PoH-Sirius/prototype1/pressure-haptics/grip_v6_clickfit_spring_variants/README.txt

V6: 着脱式クリックフィット＋ばね太さ比較版

おすすめ手順
1. 最初に PRINT_FIT_TEST_2_parts.stl を100%で印刷する。
2. テスト片を差し込み、軽いクリック感で止まり、手で引いて外せることを確認する。
3. ばねの感触を比較する場合は PRINT_SPRING_TEST_4_variants.stl を100%で印刷する。
   配置は左から1.8 / 2.0 / 2.2 / 2.4 mm。プレートから外す前に油性ペン等で太さを書く。
4. 2.0 mmばねと握り部分をまとめて交換する場合は PRINT_GRIP_3_parts_2.0mm.stl を印刷する。
5. ケースも含めて全部印刷する場合だけ full_set/PRINT_ALL_9_parts.stl を使う。ここには2.0 mmばねを収録。

変更点
- 21 x 19 mmの圧力センサー貼付面と、握りパーツ全長64 mmはV4のまま。
- ばね端を二股の弾性タブに変更。
- タブ両側に0.30 mmの傾斜付き保持突起を追加。
- 受け穴は入口4.15 mm、奥4.60 mmの二段形状。奥で突起が戻って保持する。
- 差込深さを3.3 mmから6.2 mmへ増やし、横揺れも減らした。
- 挿入と取り外しの両方向に傾斜があるため、接着せず繰り返し着脱できる。
- しなる蛇行部分だけを1.8 / 2.0 / 2.2 / 2.4 mmの4段階で用意。
- 接続タブは全種類で同じ寸法なので、同じ左右プレートへ交換して比較できる。

使い方
- ばね端を穴にまっすぐ押し込み、クリック感が出るまで差し込む。
- 外すときは握りパーツを押さえ、ばねの端に近い太い部分をまっすぐ引く。
- 蛇行している薄い部分を強くねじらない。

印刷
- PLA想定、0.4 mmノズル、積層0.20 mm、壁3周以上。
- サポートは通常不要。STLの向きを変更せず100%で印刷。
- 初層が強く潰れる設定では受け穴が狭くなるため、テスト片で先に確認。

注意
太さを上げるほど押し込み量は減り、親指側と人差し指側の振動も伝わりにくくなる一方、必要な指の力は増える。
プリンター、材料、温度で嵌合と硬さは変わるため、実機での着脱耐久と振動絶縁は未検証。
硬すぎる場合は無理に押し込まず、受け穴入口のバリだけを軽く除去する。
