PoH-Sirius/prototype1/pressure-haptics/grip_v6_clickfit_spring_variants/preview_clickfit.png

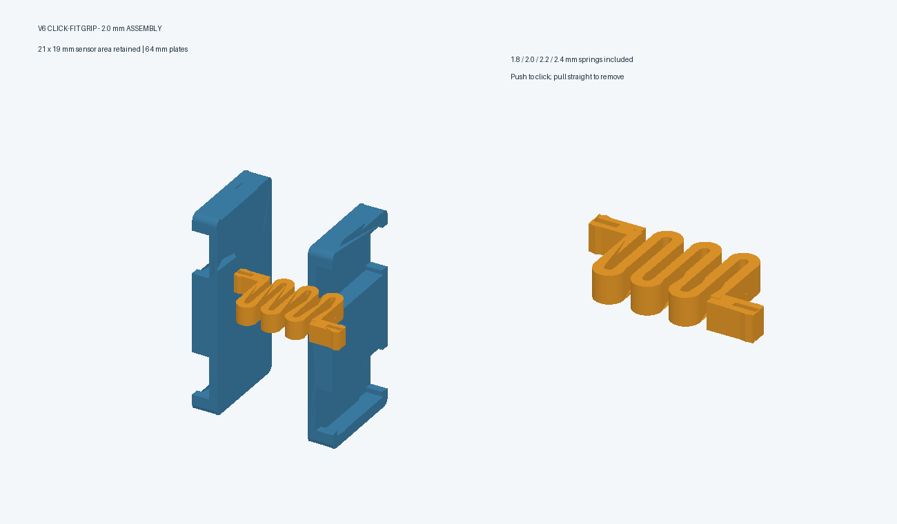
pressure-haptics/grip_v6_clickfit_spring_variants/preview_clickfit.png
