PoH-Sirius/prototype1/pressure-haptics/grip_v6_clickfit_spring_variants/grip_assembly_clickfit_2.0mm.step

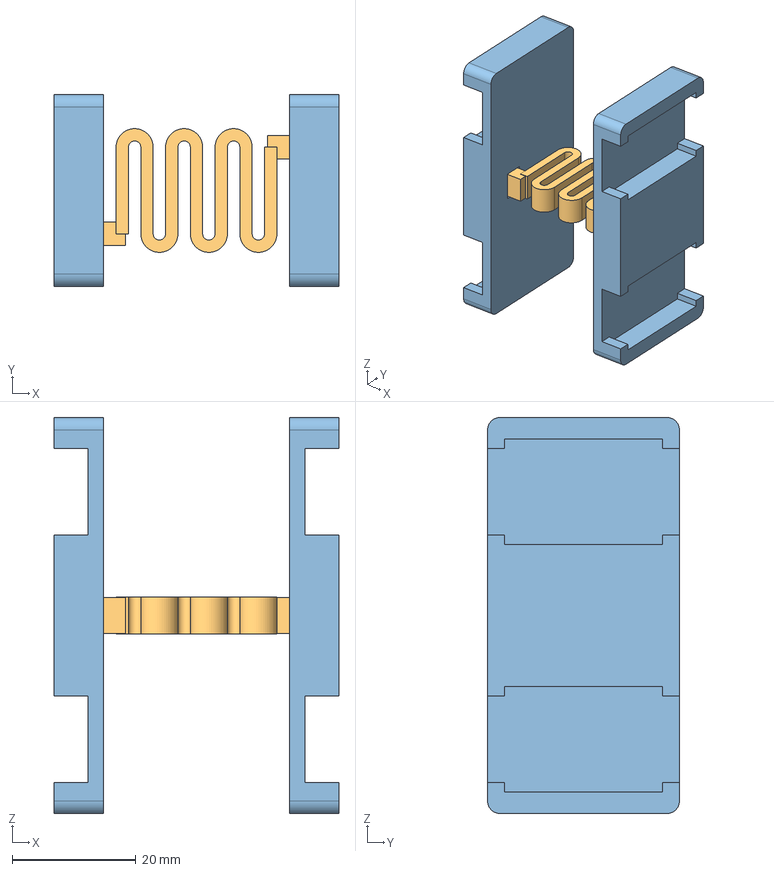
[picture p2: CAD file, 2026-09-29]
pressure-haptics/grip_v6_clickfit_spring_variants/grip_assembly_clickfit_2.0mm.step
46.0 x 31.0 x 64.0 mm
left
right
spring_clickfit
