PoH-Sirius/prototype1/pressure-haptics/grip_v6_clickfit_spring_variants/full_set/plate_left.step

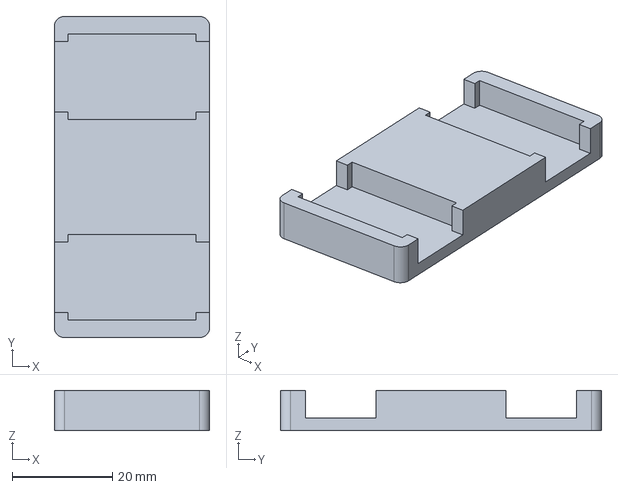
[picture p3: CAD file, 2026-09-29]
pressure-haptics/grip_v6_clickfit_spring_variants/full_set/plate_left.step
31.0 x 64.0 x 8.00 mm
