PoH-Sirius/prototype1/pressure-haptics/grip_v7_case_wiring_clearance/case_base_v7.step

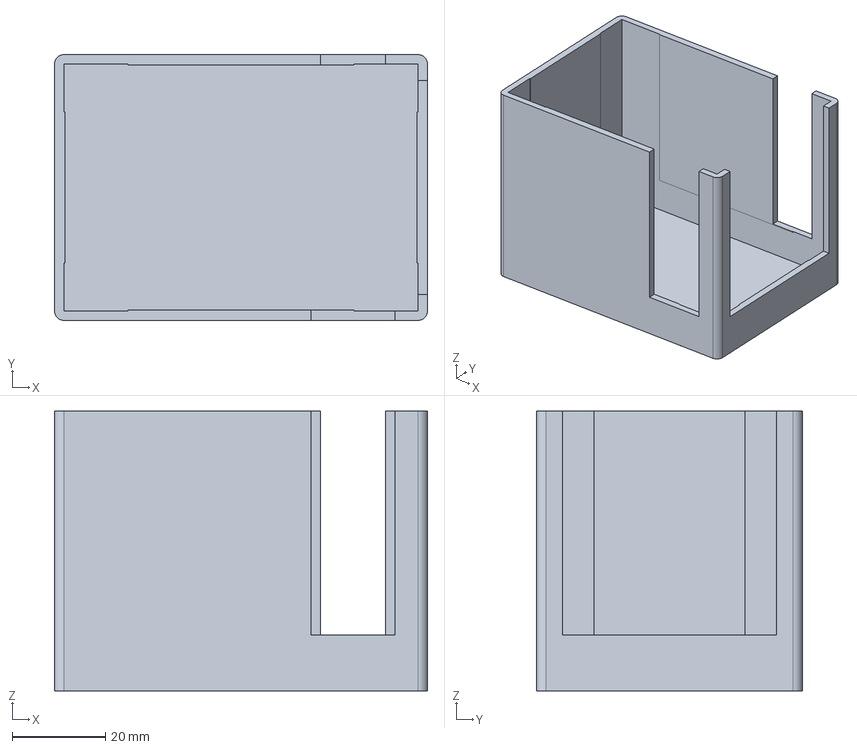
[picture p4: CAD file, 2026-09-29]
pressure-haptics/grip_v7_case_wiring_clearance/case_base_v7.step
80.0 x 57.0 x 60.0 mm
