PoH-Sirius/prototype1/pressure-haptics/grip_v7_case_wiring_clearance/full_set/print_layout_9_parts_v7.step

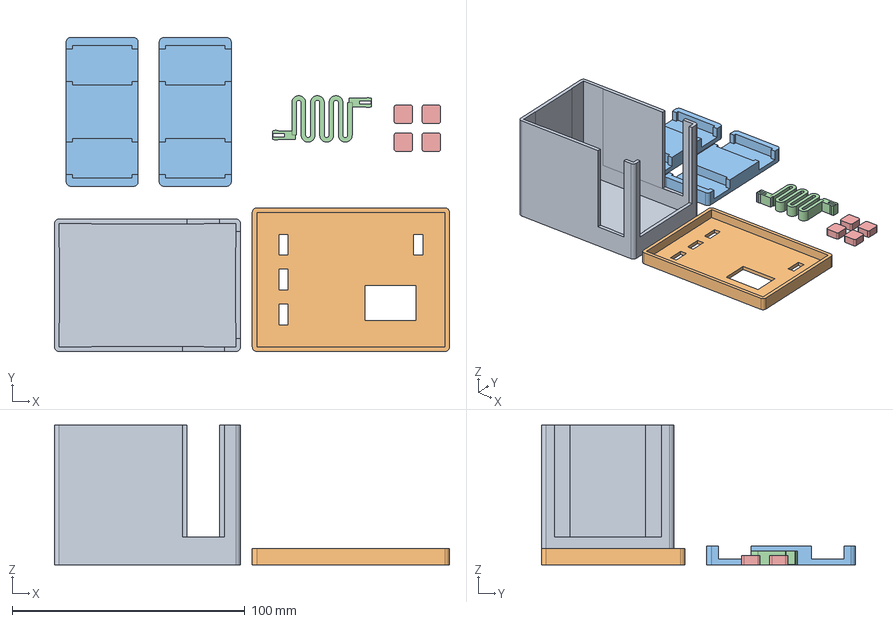
[picture p5: CAD file, 2026-09-29]
pressure-haptics/grip_v7_case_wiring_clearance/full_set/print_layout_9_parts_v7.step
169.8 x 135.0 x 60.0 mm
