PoH-Sirius/prototype1/pressure-haptics/grip_v6_clickfit_spring_variants/full_set/print_layout_9_parts.step

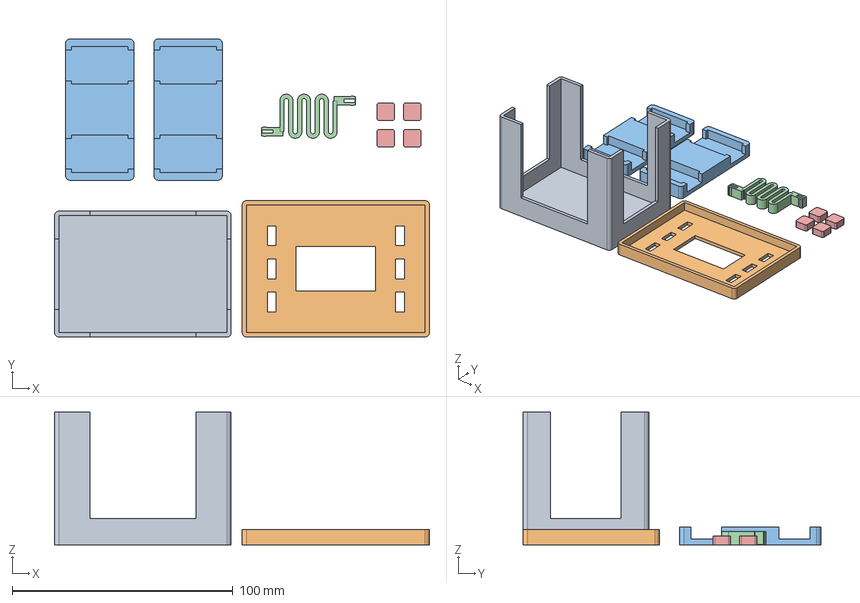
[picture p6: CAD file, 2026-09-29]
pressure-haptics/grip_v6_clickfit_spring_variants/full_set/print_layout_9_parts.step
169.8 x 135.0 x 60.0 mm
