PoH-Sirius/prototype1/pressure-haptics/grip_v6_clickfit_spring_variants/PRINT_FIT_TEST_2_parts.stl

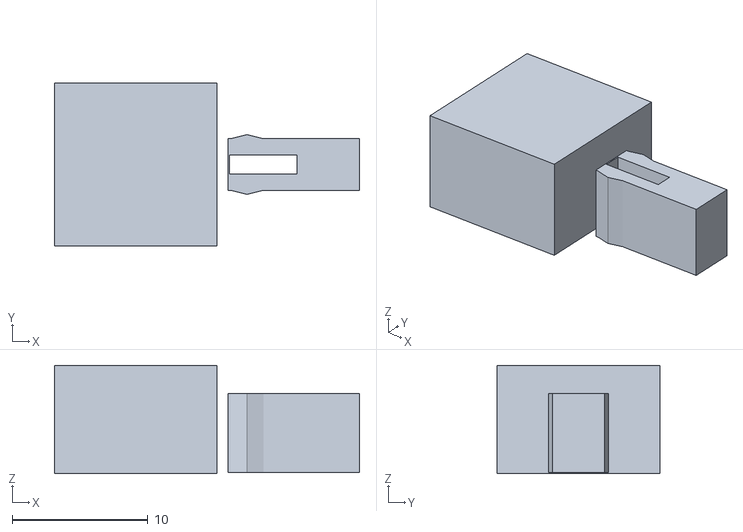
[picture p7: CAD file, 2026-09-29]
pressure-haptics/grip_v6_clickfit_spring_variants/PRINT_FIT_TEST_2_parts.stl
22.5 x 12.0 x 8.00
