PoH-Sirius/prototype1/pressure-haptics/grip_v7_case_wiring_clearance/full_set/spring_2.0mm_clickfit.step

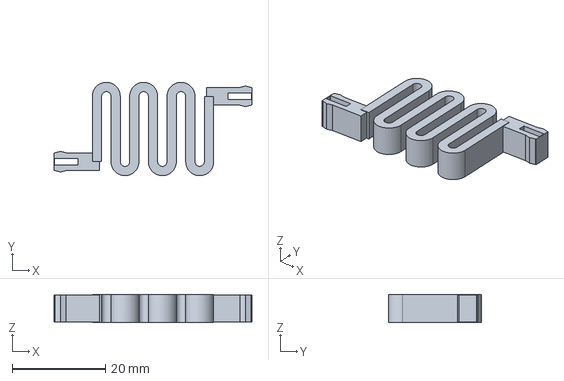
[picture p8: CAD file, 2026-09-29]
pressure-haptics/grip_v7_case_wiring_clearance/full_set/spring_2.0mm_clickfit.step
42.4 x 20.0 x 6.00 mm
