PoH-Sirius/prototype1/pressure-haptics/grip_v7_case_wiring_clearance/PRINT_CASE_V7_2_parts.step

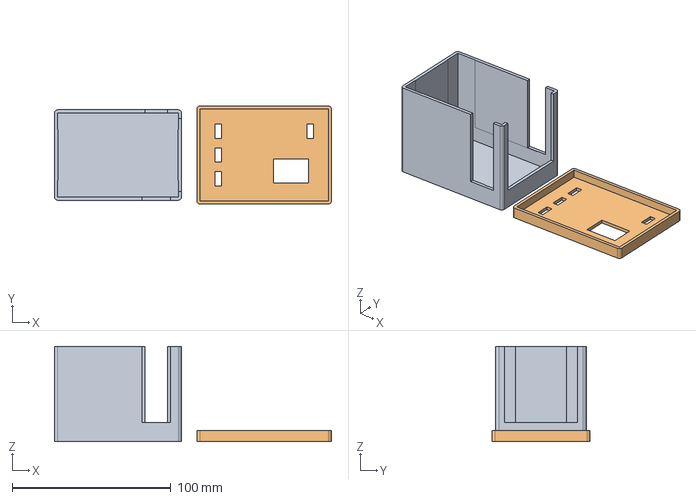
[picture p9: CAD file, 2026-09-29]
pressure-haptics/grip_v7_case_wiring_clearance/PRINT_CASE_V7_2_parts.step
174.4 x 61.8 x 60.0 mm
