PoH-Sirius/prototype1/pressure-haptics/grip_v6_clickfit_spring_variants/full_set/case_lid_print.step

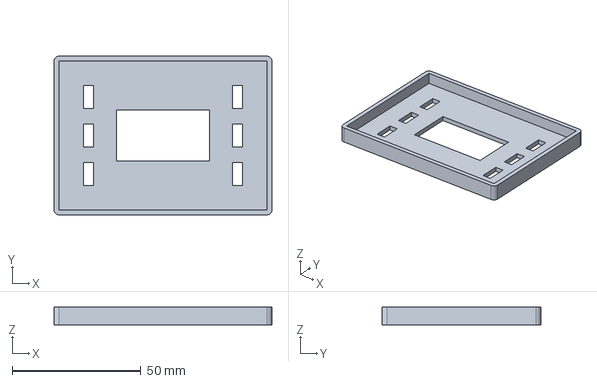
[picture p10: CAD file, 2026-09-29]
pressure-haptics/grip_v6_clickfit_spring_variants/full_set/case_lid_print.step
84.8 x 61.8 x 7.00 mm
