PoH-Sirius/prototype1/pressure-haptics/grip_v6_clickfit_spring_variants/spring_1.8mm_clickfit.step

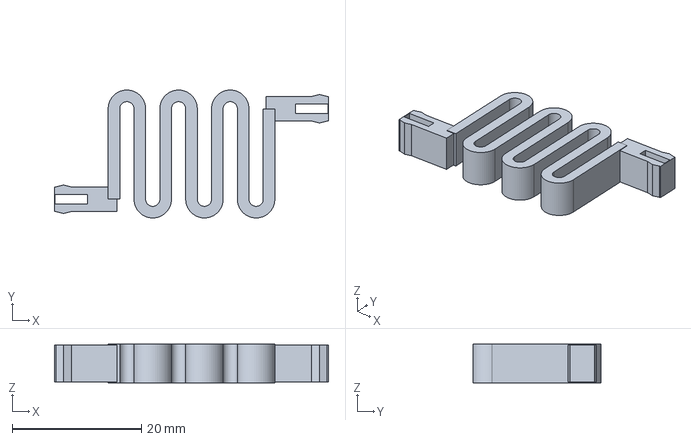
[picture p11: CAD file, 2026-09-29]
pressure-haptics/grip_v6_clickfit_spring_variants/spring_1.8mm_clickfit.step
42.4 x 19.8 x 6.00 mm
