PoH-Sirius/prototype1/pressure-haptics/grip_v7_case_wiring_clearance/full_set/support_pad.step

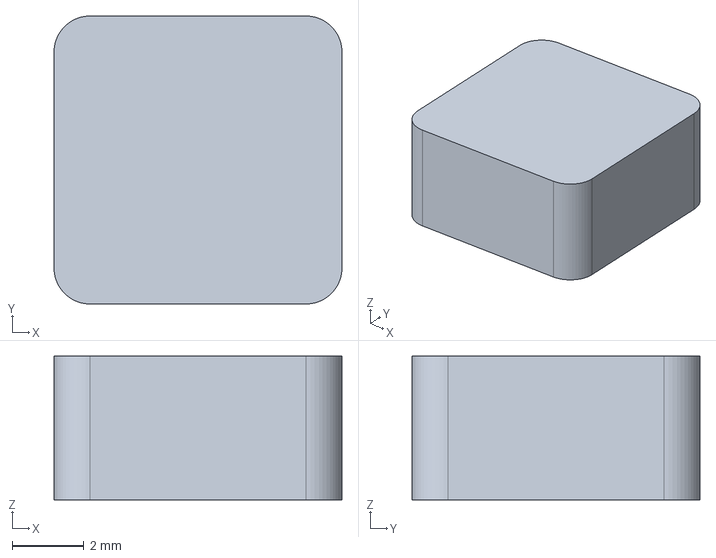
[picture p12: CAD file, 2026-09-29]
pressure-haptics/grip_v7_case_wiring_clearance/full_set/support_pad.step
8.00 x 8.00 x 4.00 mm
