PoH-Sirius/prototype1/pressure-haptics/grip_v6_clickfit_spring_variants/full_set/case_base.step

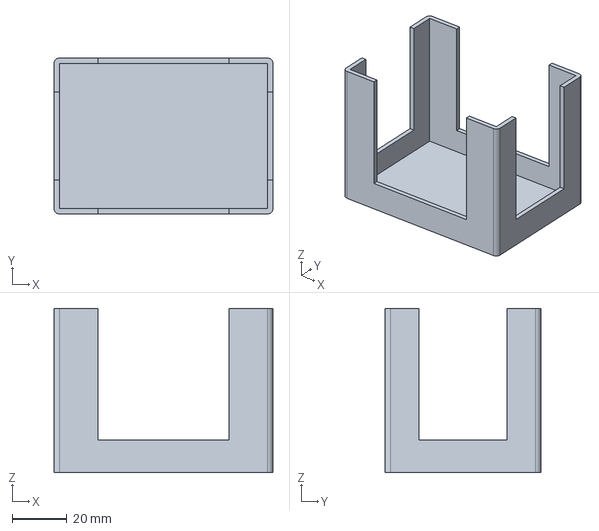
[picture p13: CAD file, 2026-09-29]
pressure-haptics/grip_v6_clickfit_spring_variants/full_set/case_base.step
80.0 x 57.0 x 60.0 mm
