PoH-Sirius/prototype1/pressure-haptics/grip_v6_clickfit_spring_variants/PRINT_SPRING_TEST_4_variants.step

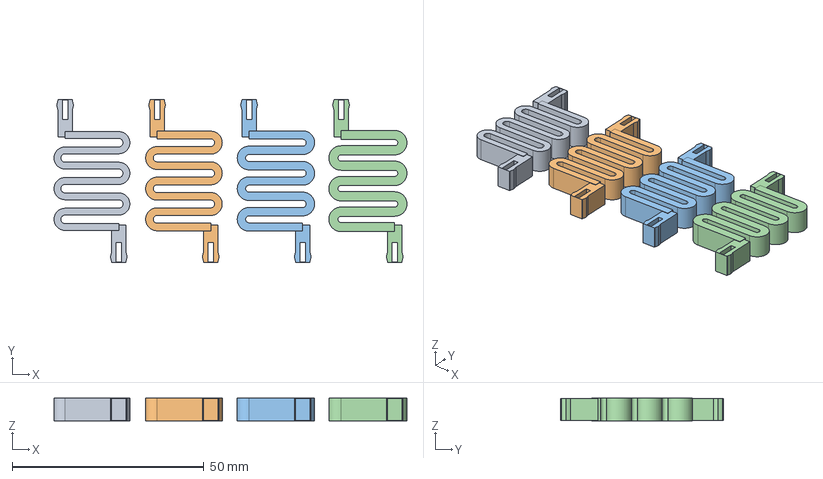
[picture p14: CAD file, 2026-09-29]
pressure-haptics/grip_v6_clickfit_spring_variants/PRINT_SPRING_TEST_4_variants.step
92.1 x 42.4 x 6.00 mm
