PoH-Sirius/prototype1/pressure-haptics/grip_v6_clickfit_spring_variants/fit_test_socket.stl

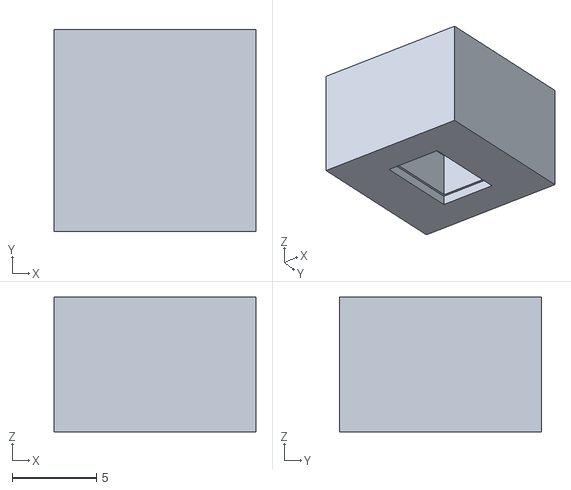
[picture p15: CAD file, 2026-09-29]
pressure-haptics/grip_v6_clickfit_spring_variants/fit_test_socket.stl
12.0 x 12.0 x 8.00
