PoH-Sirius/prototype1/pressure-haptics/grip_v6_clickfit_spring_variants/fit_test_tab.stl

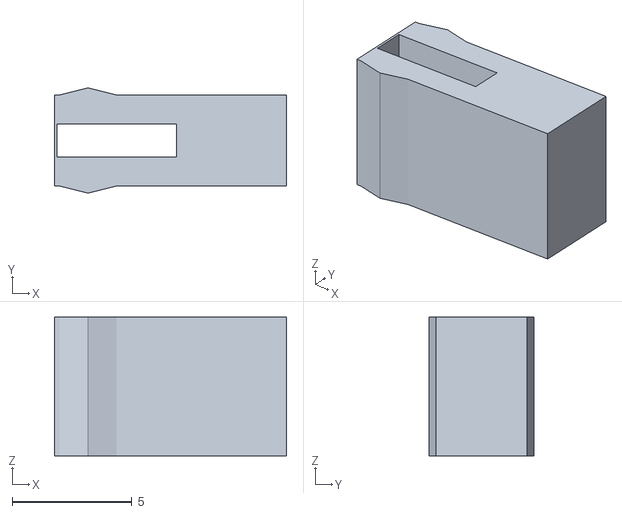
[picture p16: CAD file, 2026-09-29]
pressure-haptics/grip_v6_clickfit_spring_variants/fit_test_tab.stl
9.70 x 4.40 x 5.80
