PoH-Sirius/prototype1/pressure-haptics/grip_v6_clickfit_spring_variants/PRINT_GRIP_3_parts_2.0mm.step

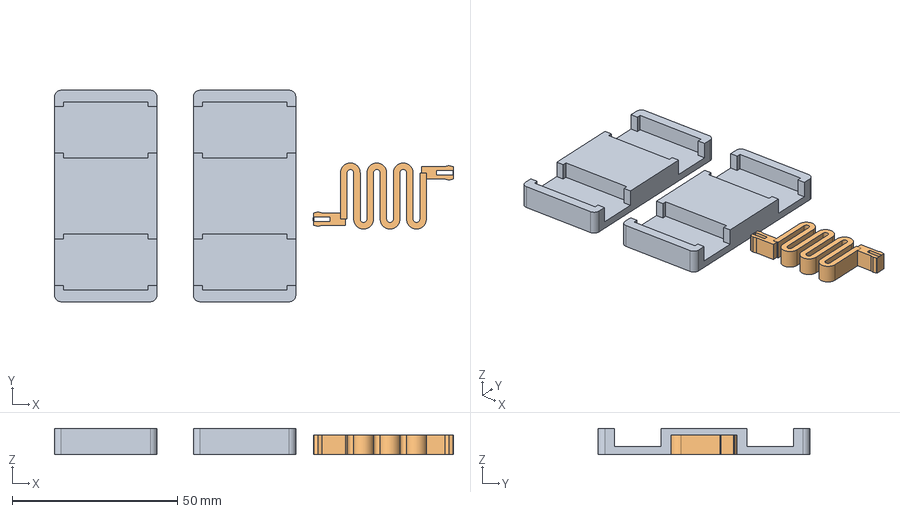
[picture p17: CAD file, 2026-09-29]
pressure-haptics/grip_v6_clickfit_spring_variants/PRINT_GRIP_3_parts_2.0mm.step
120.7 x 64.0 x 8.00 mm
