PoH-Sirius/prototype1/pressure-haptics/grip_v6_clickfit_spring_variants/spring_2.4mm_clickfit.step

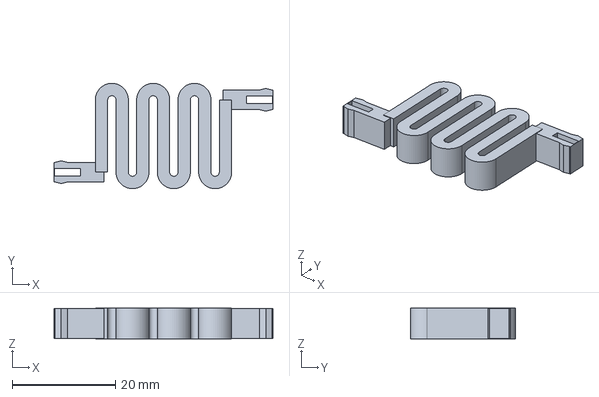
[picture p18: CAD file, 2026-09-29]
pressure-haptics/grip_v6_clickfit_spring_variants/spring_2.4mm_clickfit.step
42.4 x 20.4 x 6.00 mm
