PoH-Sirius/prototype1/(list of files, cad)

Other CAD files:
pressure-haptics/grip_v7_case_wiring_clearance/case_lid_v7.step
pressure-haptics/grip_v7_case_wiring_clearance/full_set/case_lid_v7.step
pressure-haptics/grip_v6_clickfit_spring_variants/full_set/plate_right.step
pressure-haptics/grip_v6_clickfit_spring_variants/grip_v6_clickfit_spring_variants.gcode.3mf
pressure-haptics/grip_v7_case_wiring_clearance/full_set/plate_right.step
pressure-haptics/grip_v7_case_wiring_clearance/full_set/PRINT_ALL_9_parts_v7.stl
pressure-haptics/grip_v6_clickfit_spring_variants/full_set/PRINT_ALL_9_parts.stl
pressure-haptics/grip_v6_clickfit_spring_variants/plate_right.step
pressure-haptics/grip_v6_clickfit_spring_variants/spring_2.2mm_clickfit.step
pressure-haptics/grip_v6_clickfit_spring_variants/PRINT_GRIP_3_parts_2.0mm.stl
pressure-haptics/grip_v6_clickfit_spring_variants/PRINT_SPRING_TEST_4_variants.stl
pressure-haptics/grip_v6_clickfit_spring_variants/full_set/case_base.stl
pressure-haptics/grip_v6_clickfit_spring_variants/full_set/case_lid_print.stl
pressure-haptics/grip_v6_clickfit_spring_variants/full_set/plate_left.stl
pressure-haptics/grip_v6_clickfit_spring_variants/full_set/plate_right.stl
pressure-haptics/grip_v6_clickfit_spring_variants/full_set/spring_2.0mm_clickfit.stl
pressure-haptics/grip_v6_clickfit_spring_variants/full_set/support_pad.stl
pressure-haptics/grip_v6_clickfit_spring_variants/plate_left.stl
pressure-haptics/grip_v6_clickfit_spring_variants/plate_right.stl
pressure-haptics/grip_v6_clickfit_spring_variants/spring_1.8mm_clickfit.stl
pressure-haptics/grip_v6_clickfit_spring_variants/spring_2.0mm_clickfit.stl
pressure-haptics/grip_v6_clickfit_spring_variants/spring_2.2mm_clickfit.stl
pressure-haptics/grip_v6_clickfit_spring_variants/spring_2.4mm_clickfit.stl
pressure-haptics/grip_v7_case_wiring_clearance/PRINT_CASE_V7_2_parts.stl
pressure-haptics/grip_v7_case_wiring_clearance/case_base_v7.stl
pressure-haptics/grip_v7_case_wiring_clearance/case_lid_v7.stl
pressure-haptics/grip_v7_case_wiring_clearance/full_set/case_base_v7.stl
pressure-haptics/grip_v7_case_wiring_clearance/full_set/case_lid_v7.stl
pressure-haptics/grip_v7_case_wiring_clearance/full_set/plate_left.stl
pressure-haptics/grip_v7_case_wiring_clearance/full_set/plate_right.stl
pressure-haptics/grip_v7_case_wiring_clearance/full_set/spring_2.0mm_clickfit.stl
pressure-haptics/grip_v7_case_wiring_clearance/full_set/support_pad.stl
