PoH-Sirius/prototype1/pressure-haptics/grip_v7_case_wiring_clearance/README.txt

V7：配線開口整理版（V6クリックフィット互換）

今回の変更
- ケース外寸 80 x 57 x 60 mm、蓋の嵌合、左右の握り、2.0 mmばねはV6のまま。
- 振動子4本を出す短辺の開口幅を32 mmから46 mmへ拡大。
- 振動子側と反対の短辺は、開口を完全に埋めた。
- 圧力センサー側の長辺は、振動子側へ寄せた位置に18 mm幅の開口を設置。
- 安定化電源側の長辺も、振動子側へ寄せた位置に14 mm幅の開口を設置。
- 蓋の穴は22 x 15 mmで、印刷時の反転を考慮して右下側へ配置。
- 新しい蓋穴と重なる右中央・右下の細い穴は埋め、残り4個の細い穴はV6のまま。

向き
ケースを上から見たとき、次の配置になる。

                    振動子4本
                 46 mm 開口（+X）
             ┌────────────────┐
 圧力センサー│            ■   │安定化電源
 18 mm（-Y） │            ■   │14 mm（+Y）
             └────────────────┘
                 全面閉鎖（-X）

蓋の22 x 15 mm開口中心は、上から見てケース中央から右へ17 mm、下へ10 mmオフセットしている。
組み込むときは、最も広い46 mmの開口を振動子ケーブル側へ向ける。

印刷ファイル
- PRINT_CASE_V7_2_parts.stl
  ケース本体と蓋だけ。今回の修正確認にはこれを使用する。
- full_set/PRINT_ALL_9_parts_v7.stl
  ケース、蓋、左右握り、2.0 mmばね、支持パーツ4個を含む一式。
- case_base_v7.stl / case_lid_v7.stl
  個別印刷用。
- STEPファイル
  穴位置を後からCADで微調整するときに使用する。

推奨印刷条件
- 100%サイズ。
- PLA、0.4 mmノズル、積層0.20 mm、壁3周以上。
- STLの向きは変更しない。
- ケースと蓋は通常サポート不要。

組立前の確認
1. ケースへ基板を仮置きする。
2. 蓋の右寄り開口からマイコンへケーブルを差せることを確認する。
3. 振動子4本を46 mm開口から出し、ケーブルに強い折れ・引張りがないことを確認する。
4. 振動子側へ寄せた左右の開口から、圧力センサーと安定化電源の配線が無理なく通ることを確認する。
5. 問題がなければ基板と支持パーツを固定する。

注意
写真から蓋の開口位置を合わせているため、基板の固定位置を大きく変えると穴中心がずれる。
接着前に必ず仮組みすること。

検証済み
- ケース本体・蓋はそれぞれ有効な単一ソリッド。
- ケース＋蓋の印刷データは2ソリッド。
- 一式印刷データは9ソリッド。
- 断面確認で、4つの開口が指定位置だけ貫通し、それ以外の旧開口が閉じていることを確認。
