PoH-Sirius/prototype1/pressure-haptics/grip_v7_case_wiring_clearance/preview_case_v7.png

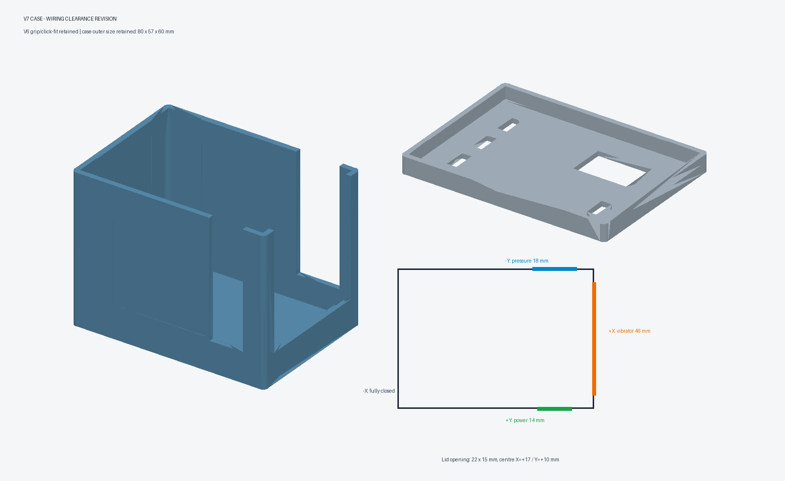
pressure-haptics/grip_v7_case_wiring_clearance/preview_case_v7.png
