PoH-Sirius/prototype1/(commit log)

2026-04-09 Colab を使用して作成されました
2026-09-29 Add pressure-distribution haptics prototype
    [PRINT_ALL_9_parts.stl, PRINT_ALL_9_parts_v7.stl, PRINT_CASE_V7_2_parts.step, PRINT_CASE_V7_2_parts.stl, PRINT_FIT_TEST_2_parts.stl, PRINT_GRIP_3_parts_2.0mm.step, PRINT_GRIP_3_parts_2.0mm.stl, PRINT_SPRING_TEST_4_variants.step]
